CharlieYu4994/ClipperOne/3D_models/3D_printing/rev4/Battery Plate_rev4_finalAdjustment.stl

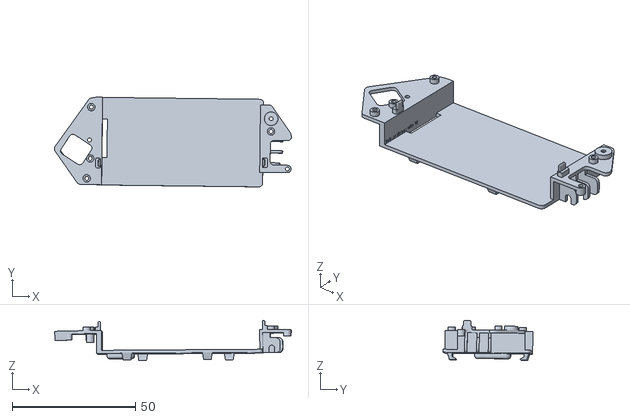
[picture p1: CAD file, 2024-11-09]
3D_models/3D_printing/rev4/Battery Plate_rev4_finalAdjustment.stl
96.0 x 36.4 x 16.3
