CharlieYu4994/ClipperOne/3D_models/3D_printing/rev4/light_guide_group_x5.stl

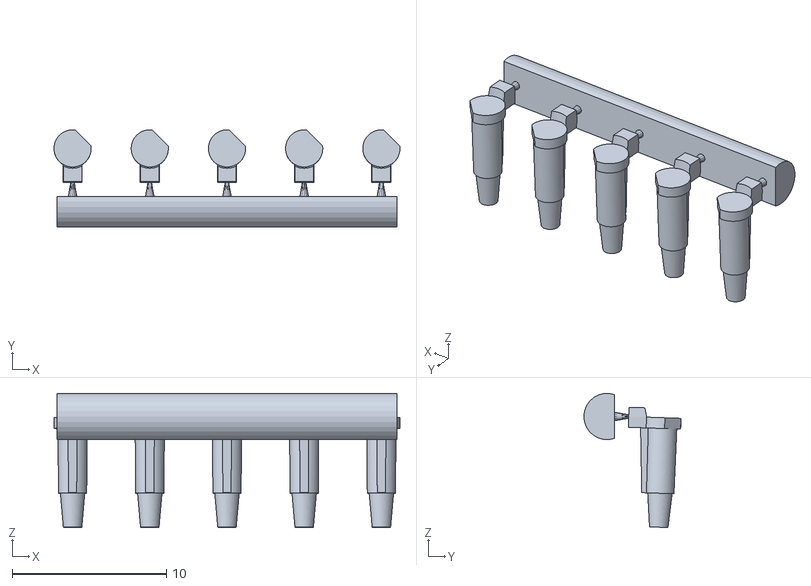
[picture p2: CAD file, 2024-11-09]
3D_models/3D_printing/rev4/light_guide_group_x5.stl
22.4 x 6.30 x 8.69
