CharlieYu4994/ClipperOne/3D_models/3D_printing/rev4/sd lanyard bracket_rev2_fixBreak.stl

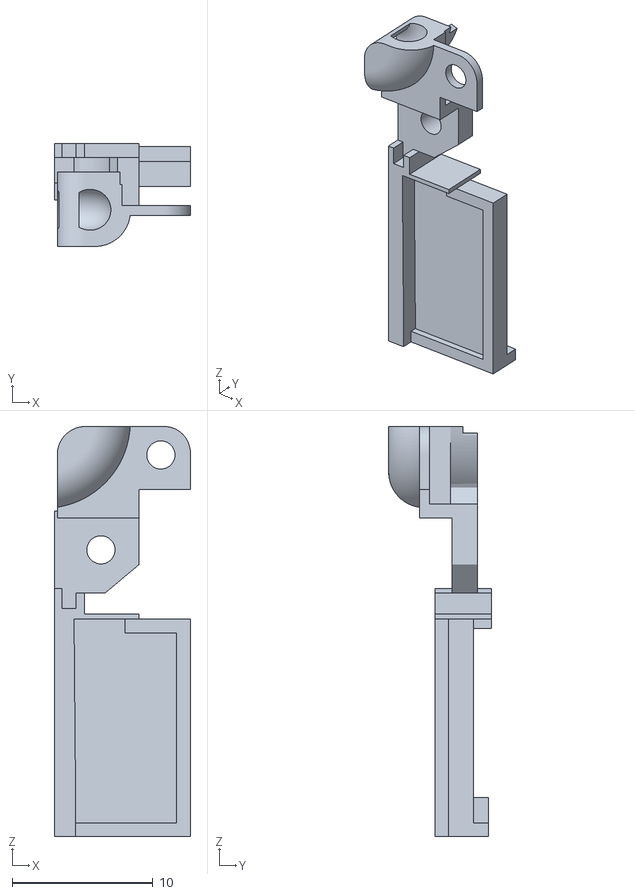
[picture p3: CAD file, 2024-11-09]
3D_models/3D_printing/rev4/sd lanyard bracket_rev2_fixBreak.stl
9.66 x 7.30 x 29.1
