CharlieYu4994/ClipperOne/3D_models/3D_printing/rev4/button_ok.stl

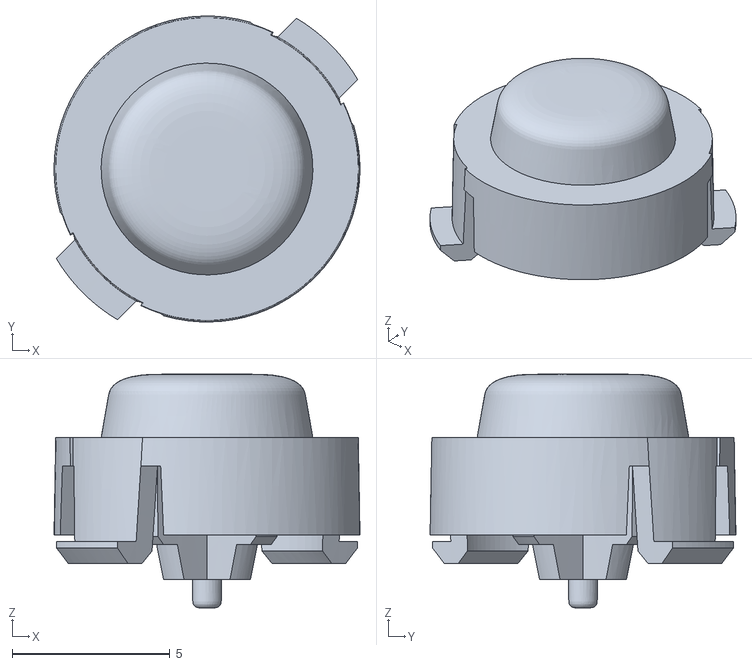
[picture p4: CAD file, 2024-11-09]
3D_models/3D_printing/rev4/button_ok.stl
9.69 x 9.69 x 7.40
