CharlieYu4994/ClipperOne/3D_models/3D_printing/rev4/上盖.stl

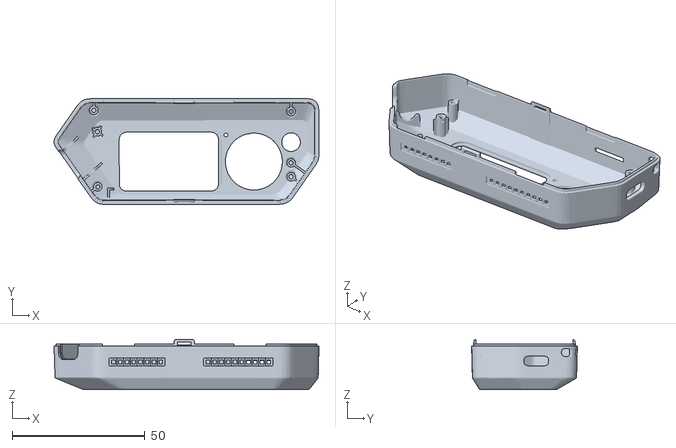
[picture p5: CAD file, 2024-11-09]
3D_models/3D_printing/rev4/上盖.stl
100.0 x 40.0 x 18.9
