CharlieYu4994/ClipperOne/3D_models/3D_printing/rev4/button_ring.stl

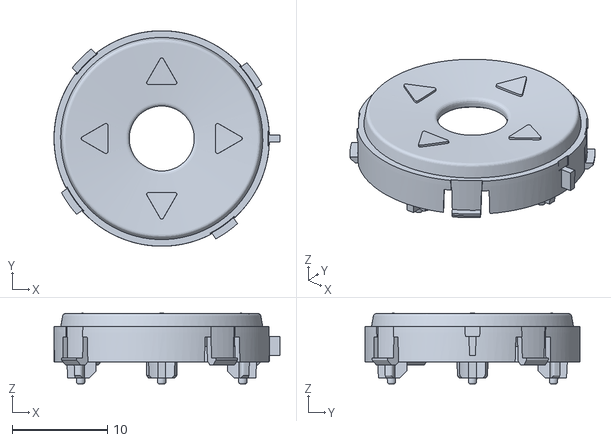
[picture p6: CAD file, 2024-11-09]
3D_models/3D_printing/rev4/button_ring.stl
23.7 x 22.6 x 7.43
