CharlieYu4994/ClipperOne/3D_models/3D_printing/rev4/下盖_rev2_fixHole.stl

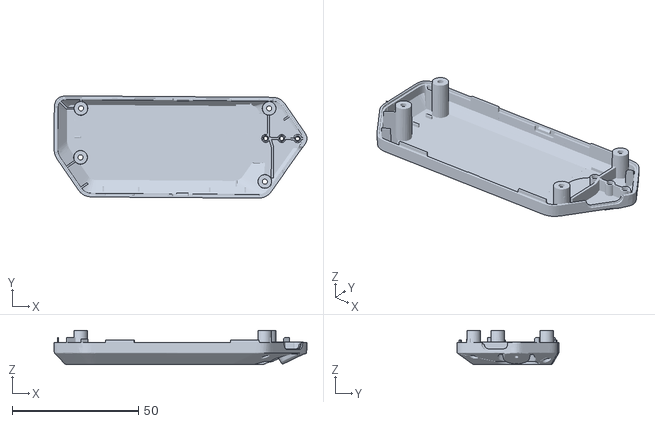
[picture p7: CAD file, 2024-11-09]
3D_models/3D_printing/rev4/下盖_rev2_fixHole.stl
100.0 x 40.4 x 13.5
