CharlieYu4994/ClipperOne/3D_models/3D_printing/rev4/button_back.stl

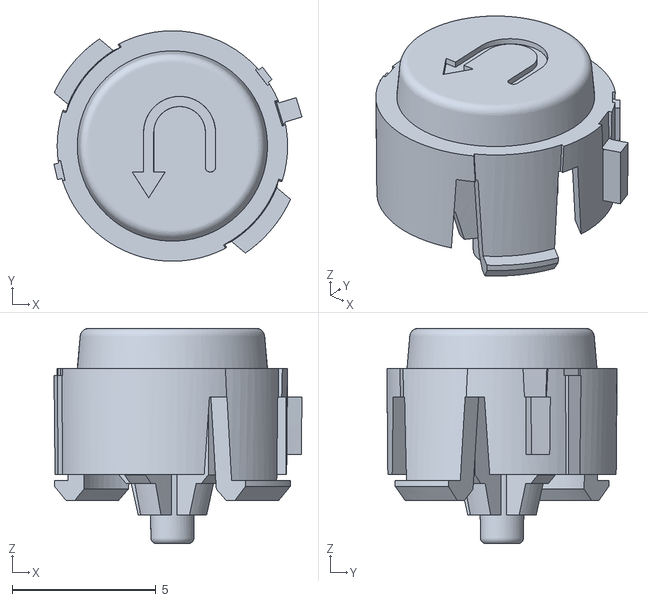
[picture p8: CAD file, 2024-11-09]
3D_models/3D_printing/rev4/button_back.stl
8.64 x 8.02 x 7.50
