CharlieYu4994/ClipperOne/Hardware/iButton/iButton.kicad_pcb

## KiCad design Hardware/iButton/iButton.kicad_pcb (2024-11-03)

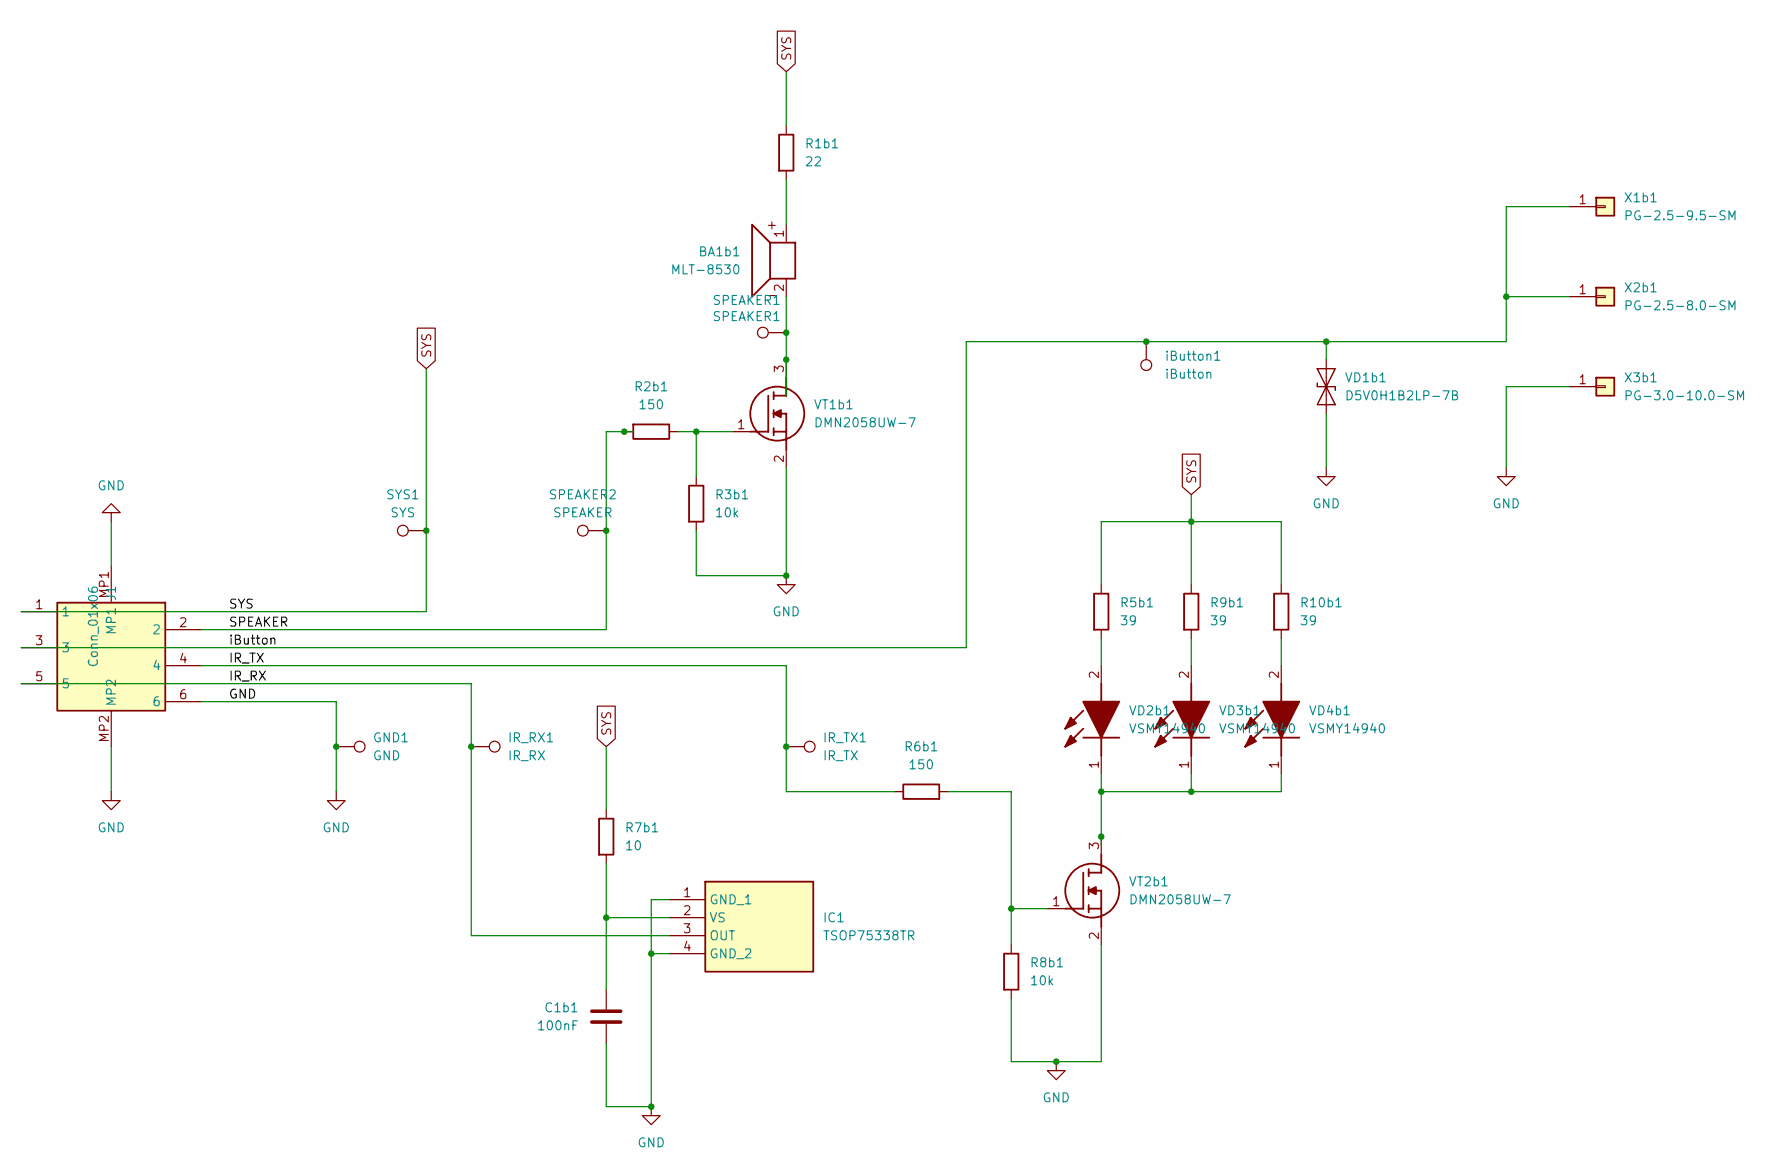
[picture p9: schematic iButton.kicad_sch]

Parts:
BA1b1: MLT-8530; MLT8530
C1b1: 100nF; C_0402_1005Metric
GND1: GND; TestPoint_Pad_D1.0mm
IC1: TSOP75338TR; Manufacturer_Part_Number TSOP75338TR; Mouser Part Number 78-TSOP75338TR
IR_RX1: IR_RX; TestPoint_Pad_D1.0mm
IR_TX1: IR_TX; TestPoint_Pad_D1.0mm
J1: Conn_01x06; AFC11S06ICC00; Manufacturer_Part_Number AFC11-S06ICC-00
R1b1: 22; R_0402_1005Metric
R2b1, R6b1: 150; R_0402_1005Metric
R3b1, R8b1: 10k; R_0402_1005Metric
R5b1, R9b1, R10b1: 39; R_0402_1005Metric
R7b1: 10; R_0402_1005Metric
SPEAKER1: SPEAKER1; TestPoint_Pad_D1.0mm
SPEAKER2: SPEAKER; TestPoint_Pad_D1.0mm
SYS1: SYS; TestPoint_Pad_D1.0mm
VD1b1: D5V0H1B2LP-7B; D5V0H1B2LP7B
VD2b1, VD3b1, VD4b1: VSMY14940; LEDC3012X261N; Manufacturer_Part_Number VSMY14940; Mouser Part Number 782-VSMY14940
VT1b1, VT2b1: DMN2058UW-7; SOT65P210X110-3N; Manufacturer_Part_Number AO3400A
X1b1: PG-2.5-9.5-SM; TestPoint_Pad_D2.0mm
X2b1: PG-2.5-8.0-SM; TestPoint_Pad_D2.0mm
X3b1: PG-3.0-10.0-SM; TestPoint_Pad_D2.0mm
iButton1: iButton; TestPoint_Pad_D1.0mm

Connections:
/IR_RX: IC1.3 (OUT), IR_RX1.1, J1.5
/IR_TX: IR_TX1.1, J1.4, R6b1.1
/SPEAKER: J1.2, R2b1.2, SPEAKER2.1
/iButton: J1.3, VD1b1.2 (A2), X1b1.1, X2b1.1, iButton1.1
GND: C1b1.2, GND1.1, IC1.1 (GND_1), IC1.4 (GND_2), J1.6, J1.MP1, J1.MP2, R3b1.2, R8b1.2, VD1b1.1 (A1), VT1b1.2 (S), VT2b1.2 (S), X3b1.1
unnamed: BA1b1.1 (+), R1b1.2
unnamed: BA1b1.2 (-), SPEAKER1.1, VT1b1.3 (D)
unnamed: C1b1.1, IC1.2 (VS), R7b1.2
unnamed: R5b1.2, VD2b1.2 (A)
unnamed: VD2b1.1 (K), VD3b1.1 (K), VD4b1.1 (K), VT2b1.3 (D)
unnamed: R9b1.2, VD3b1.2 (A)
unnamed: R10b1.2, VD4b1.2 (A)
unnamed: R2b1.1, R3b1.1, VT1b1.1 (G)
unnamed: R6b1.2, R8b1.1, VT2b1.1 (G)
SYS: J1.1, R1b1.1, R5b1.1, R7b1.1, R9b1.1, R10b1.1, SYS1.1

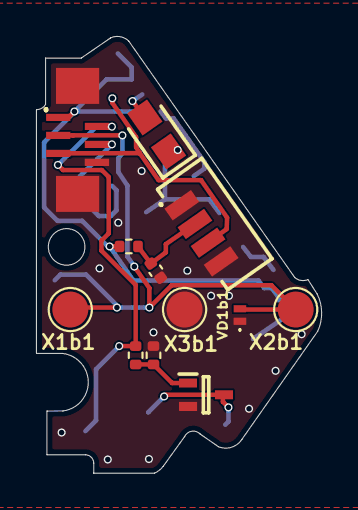
[picture p10: board iButton.kicad_pcb from above]

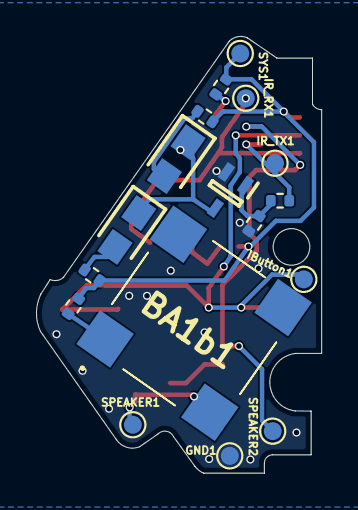
[picture p11: board iButton.kicad_pcb from below]

Board: 2 copper layers, 15.8 x 24.3 mm, 29 parts (17 on the bottom side), 15 nets.
