CharlieYu4994/ClipperOne/Hardware/main_board/main_board.kicad_pcb

## KiCad design Hardware/main_board/main_board.kicad_pcb (2024-11-11)

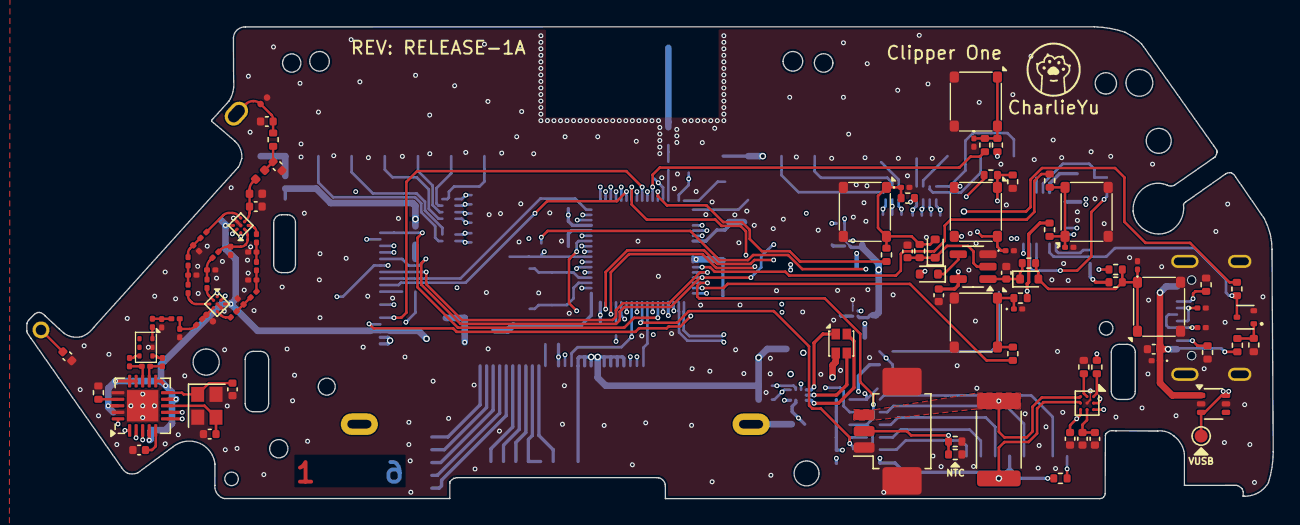
[picture p12: board main_board.kicad_pcb from above]

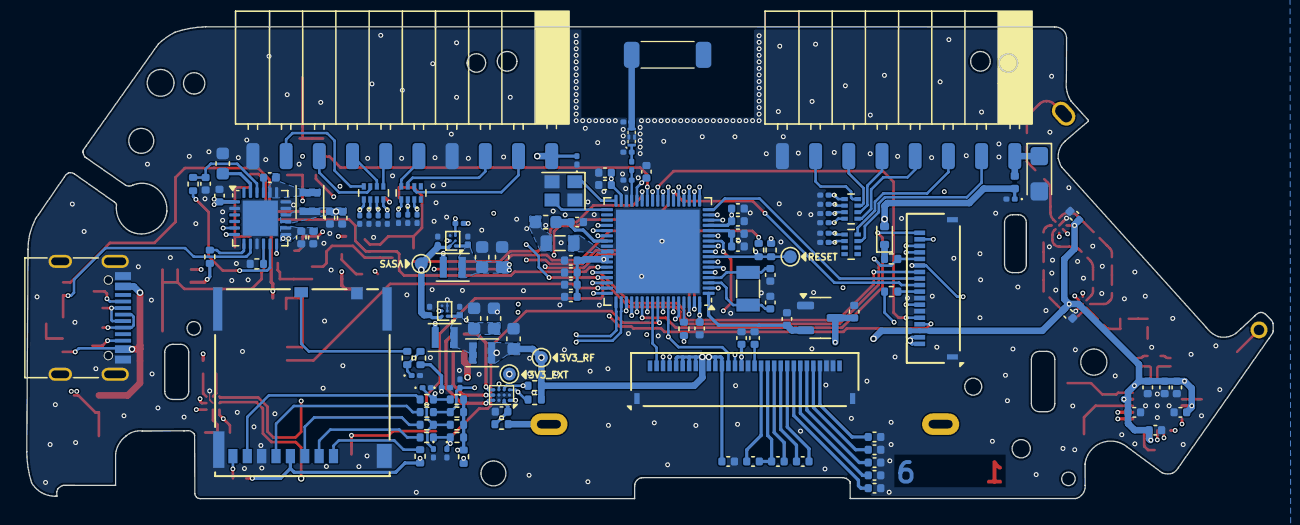
[picture p13: board main_board.kicad_pcb from below]

Board: 6 copper layers, 95.4 x 36.1 mm, 238 parts (136 on the bottom side), 165 nets.

Parts:
AE1: CrossAir C3; CrossAir-C3
AE2: Sub 1G; ANT_SUB1G
C1, C7, C11, C28: 4.7uF; C_0402_1005Metric
C2, C3, C4, C5, C8, C13, C40, C41, C42, C43, C44, C45, C46, C66, C69, C80, C82: 100nF; C_0402_1005Metric
C6, C70: 100pF; C_0402_1005Metric
C9, C12, C18, C24, C32, C33: 1uF; C_0402_1005Metric
C10, C54, C55: 10nF; C_0402_1005Metric
C14: 0.3pF; C_0201_0603Metric
C15: 0.8pF; C_0201_0603Metric
C16, C17: 18pF; C_0402_1005Metric
C19: 47nF; C_0402_1005Metric
C20, C21, C26, C27, C67, C68: 10uF; C_0402_1005Metric
C22: 470nF; C_0402_1005Metric
C23, C73, C79: 2.2uF; C_0402_1005Metric
C25, C31, C37, C38: 10uF; C_0603_1608Metric
C29, C35: 1uF; C_0201_0603Metric
C30, C36: 4.7uF; C_0603_1608Metric
C34, C39: 2.2uF; C_0201_0603Metric
C47, C49: 100pF; C_0201_0603Metric
C48: 0.6pF; C_0201_0603Metric
C50, C56, C57, C65: TBD; C_0201_0603Metric
C51: 1.2pF; C_0201_0603Metric
C52, C53: 9pF; C_0402_1005Metric
C58, C62, C63, C71, C72, C74, C75, C76, C77, C78, C83: TBD; C_0402_1005Metric
C59, C60: 10pF; C_0201_0603Metric
C61: 22pF; C_0201_0603Metric
C64: 8.2pF; C_0201_0603Metric
C81: TBD; CP_EIA-3216-18_Kemet-A
D1, D2, D3, D4, D5, D6, D11, D12, D13, D14, D15, D16, D18, D19, D20, D21, D22, D23, D24, D25, D26, D27, D28, D29, D30, D31, D32, D33, D34, D35: TVS; D_0201_0603Metric
D7, D8, D9, D17: 1N4148; D_SOD-523
D10: LED_RBGA; LTST-C19HE1WT_LTO
F1: 2A; Fuse_0402_1005Metric
FL1: DLF162500LT-5028A1; DLF162500LT
J1: BATT; Molex_PicoBlade_53261-0371_1x03-1MP_P1.25mm_Horizontal
J2: LCD; CONN30x1_FH34SRJ-30S-0.5SH50_HIR
J3: BACK_LIGHT; ERC12864FAMF03
J4: SD; CONN_503398-1892_MOL
J5: NFC; CONN18x1_FH34SRJ-18S-0.5SH50_HIR
J6: EXT1; PinSocket_1x10_P2.54mm_Horizontal_SMD
J7: EXT0; PinSocket_1x08_P2.54mm_Horizontal_SMD
J8: USB_C; USB_C_Receptacle_G-Switch_GT-USB-7010ASV
L1: 10uH; L_0603_1608Metric
L2: 10uH; L_0805_2012Metric
L3, L20, L21: 2.7nH; L_0201_0603Metric
L4: 1uH; L_Murata_DFE201610P
L5, L6, L7: 470nH; L_Murata_DFE201610P
L8: 3.3nH; L_0201_0603Metric
L9: 6.8nH; L_0201_0603Metric
L10, L11, L13, L15, L19: 0; L_0201_0603Metric
L12: 56nH; L_0201_0603Metric
L14: 27nH; L_0201_0603Metric
L16: 22nH; L_0201_0603Metric
L17: 2.2nH; L_0402_1005Metric
L18: TBD; L_0402_1005Metric
Q1: DMN313DLT; SOT-523
R1, R45, R46, R47, R50: 51R; R_0402_1005Metric
R2, R3, R8, R11, R12, R14, R19, R20, R21, R22, R23, R30, R31: 10K; R_0402_1005Metric
R4: 470R; R_0402_1005Metric
R5: 10m; R_2512_6332Metric
R6, R7, R51, R52: 5.1K; R_0402_1005Metric
R9: 5.23K; R_0402_1005Metric
R10: 30.1K; R_0402_1005Metric
R13: 100R; R_0402_1005Metric
R15: 10K; R_0201_0603Metric
R16: 0R; R_0201_0603Metric
R17: 56K/0.1%; R_0402_1005Metric
R18, R35, R36: 0R; R_0402_1005Metric
R24, R25, R26, R27, R28, R29, R33: 330R; R_0402_1005Metric
R32, R34: 100K; R_0402_1005Metric
R37, R38, R39, R40, R41, R42, R43: 47K; R_0402_1005Metric
R44, R48: 150R; R_0402_1005Metric
R49: 1K; R_0402_1005Metric
RFF**: CharlieYu; charlieyu
RN1, RN2, RN3, RN4: 51R; R_Array_Concave_4x0402
SW1: OK; SW_Push_SPST_NO_Alps_ SKRM
SW2: BACK; SW_Push_SPST_NO_Alps_ SKRM
SW3: RIGHT; SW_Push_SPST_NO_Alps_ SKRM
SW4: LEFT; SW_Push_SPST_NO_Alps_ SKRM
SW5: UP; SW_Push_SPST_NO_Alps_ SKRM
SW6: DOWN; SW_Push_SPST_NO_Alps_ SKRM
T1: B0310J50100AHF
TP1: RST; TestPoint_Pad_D1.0mm
TP12: 5V_USB; TestPoint_Pad_D1.0mm
TP18: VSYS; TestPoint_Pad_D1.0mm
TP20: 3V3_MAIN; TestPoint_Pad_D1.0mm
TP21: 3V3_EXT; TestPoint_Pad_D1.0mm
TP32: Balun; TP_DP
TP33: CC1101_OUT; TP_DP
U1: STM32WB55RGVx; QFN-68-1EP_8x8mm_P0.4mm_EP6.4x6.4mm
U2: BQ27220YZFR; Texas_DSBGA-9_1.62mmx1.58mm_Layout3x3_P0.5mm
U3: BQ25896RTWR; Texas_RTW_WQFN-24-1EP_4x4mm_P0.5mm_EP2.7x2.7mm
U4: RS3221-3.3YF3; SOT-23-3
U5: LM66100DCK; SOT-363_SC-70-6
U6, U7: LM3281YFQR; BGA-6_2x3_1.16x1.435mm
U8: CC1101RGP; Texas_RGP0020H_VQFN-20-1EP_4x4mm_P0.5mm_EP2.4x2.4mm
U9, U10: BGS13S4N9E6327XTSA1; BGA-9_3x3_1.2x1.2mm
U11: NC7SZ32M5X; SOT-23-5
U12: LP5562TMX; BGA-12_4x3_1.6x1.2mm
Y1: 32MHz; Crystal_SMD_2520-4Pin_2.5x2.0mm
Y2: 32.768K; Crystal_SMD_3215-2Pin_3.2x1.5mm
Y3: 26MHz; Crystal_SMD_2520-4Pin_2.5x2.0mm

Connections:
+3.3V: C1.2, C2.2, C3.2, C4.2, C5.2, C6.2, C7.2, C8.2, C9.2, C10.2, C38.2, C40.2, C41.2, C42.2, C43.2, C44.2, C45.2, C54.1, C55.1, C66.1, C69.2, C70.2, J2.5, J2.6, J2.7, J2.8, J2.9, J2.10, J2.11, J2.12, J2.15, J5.3, L7.2, R2.1, R6.2, R7.2, R8.2, R15.1, R19.2, R20.2, R21.2, R22.2, R23.2, R31.2, SW1.2, TP20.1, U1.14 (VDDA), U1.30 (VDD), U1.33 (VDDRF), U1.44 (VDDSMPS), U1.45 (VDD), U1.55 (VDDUSB), U1.68 (VDD), U8.4 (DVDD), U8.9 (AVDD), U8.11 (AVDD), U8.14 (AVDD), U8.15 (AVDD), U8.18 (DGUARD), U9.A3 (VDD), U10.A3 (VDD), U11.5 (VCC)
+3.3V_EXT: C30.2, C31.2, C34.2, D18.2 (A2), J6.1, L5.2, R36.1, TP21.1, U6.A1 (FB)
+3.3V_LDO: C33.2, U1.1 (VBAT), U4.2 (VOUT)
/Buttons/BACK: D2.1 (A1), D7.2 (A), R19.1, R25.2, R32.2, SW2.1
/Buttons/BUTTON_BACK: R25.1, U1.2 (PC13), U3.12 (QON_N)
/Buttons/BUTTON_DOWN: R29.1, U1.50 (PC6)
/Buttons/BUTTON_LEFT: R27.1, U1.29 (PB11)
/Buttons/BUTTON_OK: R24.1, U1.5 (PH3)
/Buttons/BUTTON_RIGHT: R26.1, U1.46 (PB12)
/Buttons/BUTTON_UP: R28.1, U1.28 (PB10)
/Buttons/LEFT: D4.1 (A1), D9.2 (A), R21.1, R27.2, R34.2, SW4.1
/Buttons/RESET: R31.1, R33.1, TP1.1, U1.8 (NRST), U12.C3 (EN_VCC)
/CC1101/CC1101_CS: U1.61 (PD0), U8.7 (CSN)
/CC1101/CC1101_G0: U1.16 (PA1), U8.6 (GDO0)
/CC1101/CC1101_UBAL: R16.2, TP32.1, U9.C2 (RFIN)
/CC1101/RF_SW_0: U1.25 (PC4), U9.A2 (V2), U10.A1 (V1)
/CC1101/RF_SW_1: U8.3 (GD02), U9.A1 (V1), U10.A2 (V2)
/CC1101/SPI_R_MISO: R50.1, U1.64 (PB4), U8.2 (SO)
/CC1101/SPI_R_MOSI: J5.13, R1.2, U8.20 (SI)
/CC1101/SPI_R_SCK: J5.7, U1.20 (PA5), U8.1 (SCLK)
/LCD/DISPLAY_CS: J2.2, U1.59 (PC11)
/LCD/DISPLAY_DI: J2.4, U1.39 (PB1)
/LCD/DISPLAY_RST: J2.3, U1.38 (PB0)
/LCD/LCD_LED: J3.1 (K), U12.A1 (W)
/LCD/SPI_D_MOSI: D12.1 (A1), J2.14, R38.1, R45.1, U1.49 (PB15)
/LCD/SPI_D_SCK: D13.1 (A1), J2.13, R39.1, R46.1, U1.62 (PD1)
/MCU/D+: D35.1 (A1), J8.A6 (D+), J8.B6 (D+), U1.53 (PA12)
/MCU/D-: D34.1 (A1), J8.A7 (D-), J8.B7 (D-), U1.52 (PA11)
/MCU/I2C_SCL: R7.1, U1.24 (PA9), U2.A3 (SCL), U3.5 (SCL), U12.C2 (SCL)
/MCU/I2C_SDA: R6.1, U1.51 (PA10), U2.A2 (SDA), U3.6 (SDA), U12.C1 (SDA)
/MCU/IR_RX: J5.17, U1.15 (PA0)
/MCU/IR_TX: J5.16, U1.7 (PB9)
/MCU/NFC_CS: J5.4, U1.40 (PE4)
/MCU/PA4: D22.1 (A1), RN3.8, U1.19 (PA4)
/MCU/PA6: D21.1 (A1), RN1.5, U1.21 (PA6)
/MCU/PA7: D20.1 (A1), RN1.6, U1.22 (PA7)
/MCU/PB2: D24.1 (A1), RN3.6, U1.27 (PB2)
/MCU/PB3: D23.1 (A1), RN3.7, U1.63 (PB3)
/MCU/PC0: D31.1 (A1), RN4.6, U1.9 (PC0)
/MCU/PC1: D30.1 (A1), RN4.7, U1.10 (PC1)
/MCU/PC3: D25.1 (A1), RN3.5, U1.12 (PC3)
/MCU/PERI_EN: R15.2, U1.18 (PA3), U6.C1 (EN)
/MCU/RFID_CARRIER: J5.18, U1.57 (PA15)
/MCU/RFID_OUT: J5.12, U1.47 (PB13)
/MCU/RFID_PULL: J5.11, U1.17 (PA2)
/MCU/RFID_RF_IN: J5.5, U1.26 (PC5)
/MCU/SD_CD: D15.1 (A1), R41.1, R48.1, U1.58 (PC10)
/MCU/SD_CS: D11.1 (A1), R37.1, R44.1, U1.60 (PC12)
/MCU/SPEAKER: J5.15, U1.6 (PB8)
/MCU/SPI_D_MISO: D14.1 (A1), R40.1, R47.1, U1.11 (PC2)
/MCU/SWCLK: D26.1 (A1), RN2.7, U1.56 (PA14)
/MCU/SWDIO: D27.1 (A1), RN2.6, U1.54 (PA13)
/MCU/UART1_RX: D29.1 (A1), RN4.8, U1.67 (PB7)
/MCU/UART1_TX: D28.1 (A1), RN2.5, U1.66 (PB6)
/MCU/VIBRO: J5.10, U1.23 (PA8)
/MCU/iBTN: D32.1 (A1), J5.14, R49.2, RN4.5, U1.48 (PB14)
/Power/BAT+: C18.2, J1.3, R5.2, U2.C1 (SRP), U2.C3 (BAT)
BAT: C26.2, C27.2, C32.2, R5.1, U2.C2 (SRN), U3.13 (BAT), U3.14 (BAT), U4.3 (VIN)
GND: C1.1, C2.1, C3.1, C4.1, C5.1, C6.1, C7.1, C8.1, C9.1, C10.1, C11.1, C12.1, C13.1, C14.1, C15.1, C16.1, C17.1, C18.1, C20.1, C21.1, C22.1, C23.1, C24.1, C25.1, C26.1, C27.1, C28.1, C29.1, C30.1, C31.1, C32.1, C33.1, C34.1, C35.1, C36.1, C37.1, C38.1, C39.1, C40.1, C41.1, C42.1, C43.1, C44.1, C45.1, C46.2, C50.1, C51.1, C52.1, C53.1, C54.2, C55.2, C56.2, C57.2, C58.2, C59.1, C60.1, C61.1, C62.1, C63.1, C64.1, C65.1, C66.2, C67.1, C68.1, C69.1, C70.1, C71.1, C75.1, C76.1, C77.1, C78.1, C79.1, C80.2, C81.2, C82.2, C83.1, D1.2 (A2), D2.2 (A2), D3.2 (A2), D4.2 (A2), D5.2 (A2), D6.2 (A2), D11.2 (A2), D12.2 (A2), D13.2 (A2), D14.2 (A2), D15.2 (A2), D16.2 (A2), D18.1 (A1), D19.2 (A2), D20.2 (A2), D21.2 (A2), D22.2 (A2), D23.2 (A2), D24.2 (A2), D25.2 (A2), D26.2 (A2), D27.2 (A2), D28.2 (A2), D29.2 (A2), D30.2 (A2), D31.2 (A2), D32.2 (A2), D33.2 (A2), D34.2 (A2), D35.2 (A2), FL1.2 (GND), FL1.4 (GND), J1.1, J1.MP (MountPin), J2.16, J2.28, J2.29, J2.MP (MountPin), J4.6 (VSS), J4.10 (SHIELD), J5.6, J5.8, J5.MP (MountPin), J6.4, J6.10, J7.8, J8.A1 (GND), J8.A12 (GND), J8.B1 (GND), J8.B12 (GND), J8.S1 (SHIELD), L18.1, L21.1, Q1.2 (S), R3.2, R4.1, R10.1, R11.1, R14.1, R17.2, R30.1, R51.1, R52.1, SW2.2, SW3.2, SW4.2, SW5.2, SW6.2, T1.2 (GND), TP32.2, TP33.2, U1.32 (VSSRF), U1.42 (VSSSMPS), U1.69 (VSS), U2.B2 (VSS), U3.2 (PSEL), U3.9 (CE_N), U3.17 (PGND), U3.18 (PGND), U3.25 (PAD), U4.1 (GND), U5.2 (GND), U5.5 (ST), U6.C2 (EPAD), U7.B1 (MODE), U7.C1 (EN), U7.C2 (EPAD), U8.16 (GND), U8.19 (GND), U8.21 (EPAD), U9.B2 (GND), U9.B3 (DGND), U10.B2 (GND), U10.B3 (DGND), U11.3 (GND), U12.A3 (CLK_32K), U12.B1 (A1), U12.B2 (A0), U12.B3 (GND), Y1.2, Y1.4, Y3.2, Y3.4
unnamed: AE1.1 (FEED), FL1.3 (OUT), L21.2
unnamed: AE2.1 (A), C63.2, R18.2, TP33.1
unnamed: AE2.2 (Shield), C83.2
unnamed: C47.2, T1.4 (Bal)
unnamed: C49.2, T1.3 (Bal)
unnamed: C50.2, L8.2, L9.1
unnamed: C51.2, L9.2, R16.1
unnamed: C56.1, L10.2, L11.1
unnamed: C57.1, L11.2, L12.1
unnamed: C59.2, L13.2, L14.1
unnamed: C60.2, L14.2, L15.1
unnamed: C61.2, L15.2, L16.1
unnamed: C62.2, L17.2, R18.1
unnamed: C64.2, L19.2, L20.1
unnamed: D1.1 (A1), R24.2, R30.2, SW1.1
unnamed: D3.1 (A1), R20.1, R26.2, SW3.1
unnamed: D5.1 (A1), R22.1, R28.2, SW5.1
unnamed: D6.1 (A1), R23.1, R29.2, SW6.1
unnamed: C67.2, D7.1 (K), R32.1, U11.1
unnamed: D8.2 (A), R33.2
unnamed: D8.1 (K), U11.4
unnamed: C68.2, D9.1 (K), R34.1, U11.2
unnamed: D10.2 (BK), U12.A4 (B)
unnamed: D10.3 (GK), U12.B4 (G)
unnamed: D10.1 (RK), U12.C4 (R)
unnamed: D16.1 (A1), J4.4 (VDD), R36.2, R37.2, R38.2, R39.2, R40.2, R41.2, R42.2, R43.2
unnamed: D17.1 (K), R49.1
unnamed: C14.2, FL1.1 (IN), L3.1
unnamed: J1.2, R9.2, R10.2, R11.2, U3.11 (TS)
unnamed: C71.2, J2.17
unnamed: C72.2, J2.18
unnamed: C72.1, C73.2, J2.19
unnamed: C73.1, J2.20
unnamed: C74.2, J2.21
unnamed: C74.1, J2.22
unnamed: C75.2, J2.23
unnamed: C76.2, J2.24
unnamed: C77.2, J2.25
unnamed: C78.2, J2.26
unnamed: C79.2, J2.27
unnamed: J3.2 (A), R35.1
unnamed: J4.5 (CLK), R46.2
unnamed: J4.3 (CMD), R45.2
unnamed: J4.7 (DAT0), R47.2
unnamed: J4.8 (DAT1), R42.1
unnamed: J4.1 (DAT2), R43.1
unnamed: J4.2 (DAT3/CD), R44.2
unnamed: J4.9 (DET), R48.2
unnamed: J5.9, R50.2
unnamed: J6.2, RN2.2
unnamed: J6.3, RN2.3
unnamed: J6.5, RN2.4
unnamed: J6.6, RN4.1
unnamed: J6.7, RN4.2
unnamed: J6.8, RN4.3
unnamed: J6.9, RN4.4
unnamed: C81.1, F1.2, J7.1
unnamed: J7.2, RN1.3
unnamed: J7.3, RN1.4
unnamed: J7.4, RN3.1
unnamed: J7.5, RN3.2
unnamed: J7.6, RN3.3
unnamed: J7.7, RN3.4
unnamed: J8.A5 (CC1), R52.2
unnamed: J8.B5 (CC2), R51.2
unnamed: L1.2, L2.1
unnamed: Q1.3 (D), R12.2, U3.8 (OTG_IUSB)
unnamed: Q1.1 (G), R13.2, R14.2
unnamed: L8.1, T1.1 (Unbal)
unnamed: U1.35 (OSC_IN), Y1.3
unnamed: U1.34 (OSC_OUT), Y1.1
unnamed: R1.1, U1.65 (PB5)
unnamed: C16.2, U1.3 (PC14), Y2.2
unnamed: C17.2, U1.4 (PC15), Y2.1
unnamed: C15.2, L3.2, U1.31 (RF1)
unnamed: C11.2, L1.1, U1.41 (VFBSMPS)
unnamed: L2.2, U1.43 (VLXSMPS)
unnamed: C12.2, C13.2, U1.13 (VREF+)
unnamed: R3.1, U2.B1 (BIN)
unnamed: R2.2, U2.A1 (GPOUT)
unnamed: C22.2, C23.2, U2.B3 (VDD)
unnamed: C19.1, U3.21 (BTST)
unnamed: R4.2, U3.10 (ILIM)
unnamed: R8.1, U3.7 (INT)
unnamed: C25.2, U3.23 (PMID)
unnamed: C28.2, R9.1, U3.22 (REGN)
unnamed: L5.1, U6.B2 (SW)
unnamed: C36.2, C37.2, C39.2, L6.2, L7.1, U7.A1 (FB)
unnamed: L6.1, U7.B2 (SW)
unnamed: C46.1, U8.5 (DCOUPL)
unnamed: R17.1, U8.17 (RBIAS)
unnamed: C47.1, C48.1, U8.13 (RF_N)
unnamed: C48.2, C49.1, U8.12 (RF_P)
unnamed: C52.2, U8.8 (XOSC_Q1), Y3.3
unnamed: C53.2, U8.10 (XOSC_Q2), Y3.1
unnamed: L10.1, U9.C1 (RF1)
unnamed: L13.1, U9.C3 (RF2)
unnamed: L19.1, U9.B1 (RF3)
unnamed: L16.2, U10.C1 (RF1)
unnamed: L12.2, U10.C3 (RF2)
unnamed: C65.2, L20.2, U10.B1 (RF3)
unnamed: C58.1, L17.1, L18.2, U10.C2 (RFIN)
SW: C19.2, L4.1, U3.19 (SW), U3.20 (SW)
VBUS: C82.1, D33.1 (A1), J8.A4 (VBUS), J8.A9 (VBUS), J8.B4 (VBUS), J8.B9 (VBUS), R13.1, U5.1 (VIN)
VSYS: C20.2, C21.2, C29.2, C35.2, C80.1, D10.4 (A), L4.2, R12.1, R35.2, TP18.1, U3.15 (SYS), U3.16 (SYS), U6.A2 (VIN), U6.B1 (MODE), U7.A2 (VIN), U12.A2 (VDD)
VUSB: C24.2, D17.2 (A), D19.1 (A1), F1.1, J5.1, J5.2, TP12.1, U3.1 (VBUS), U5.3 (~CE), U5.6 (VOUT)
