CharlieYu4994/ClipperOne/Hardware/nfc_rfid/nfc_rfid.kicad_pcb

## KiCad design Hardware/nfc_rfid/nfc_rfid.kicad_pcb (2024-11-09)

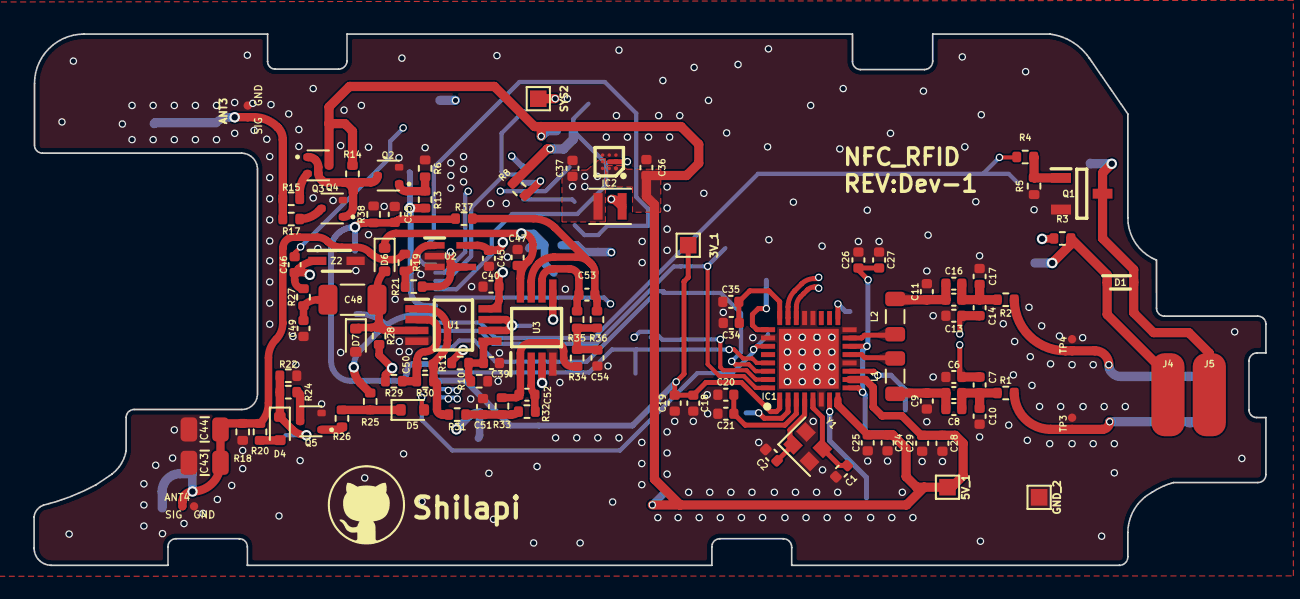
[picture p14: board nfc_rfid.kicad_pcb from above]

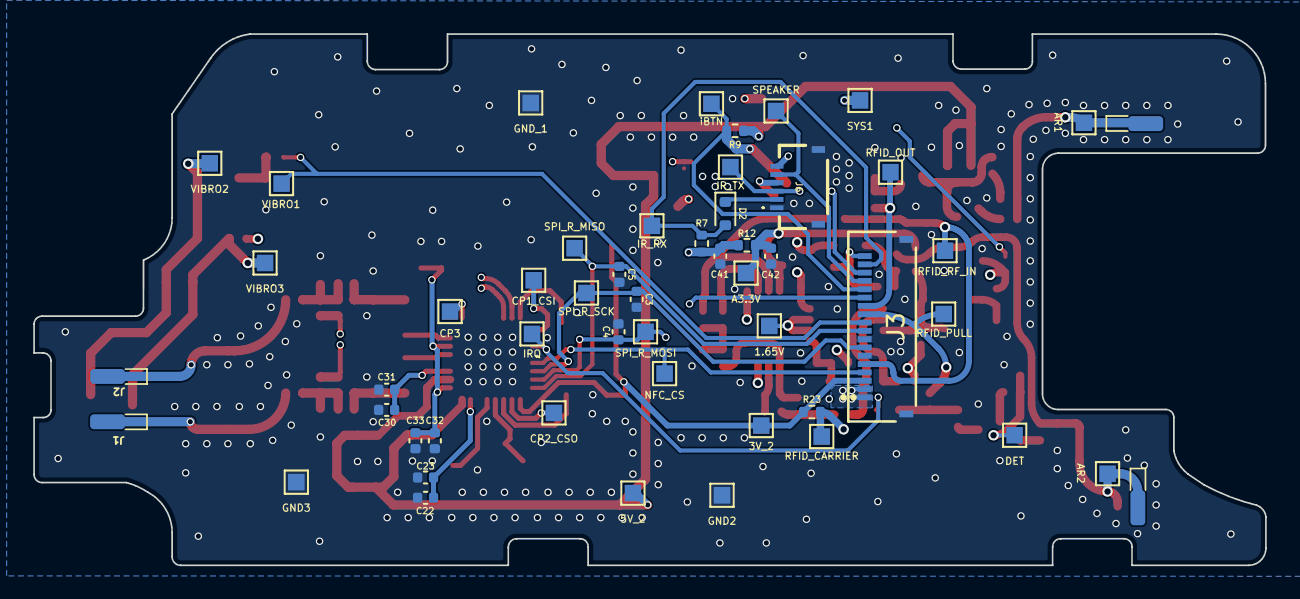
[picture p15: board nfc_rfid.kicad_pcb from below]

Board: 4 copper layers, 74.1 x 32.0 mm, 158 parts (52 on the bottom side), 68 nets.

Parts:
C1, C2: 6pF; C_0402_1005Metric
C3, C4, C5, C12, C15, C50: C; C_0402_1005Metric
C6, C8, C13, C16, C52, C53, C55: 100pF; C_0402_1005Metric
C7, C14: 10pF; C_0402_1005Metric
C9, C11: 680pF; C_0402_1005Metric
C10, C17: 62pF; C_0402_1005Metric
C18, C20, C22, C24, C26, C28, C30, C32, C34, C46: 10nF; C_0402_1005Metric
C19, C21, C23, C25, C27, C29, C31, C33, C35: 2.2uF; C_0402_1005Metric
C36: 22uF; C_0402_1005Metric
C37: 10uF; C_0402_1005Metric
C39, C41, C42: 1uF; C_0402_1005Metric
C40, C45, C47: 100nF; C_0402_1005Metric
C43: 3.3nF; C_0805_2012Metric
C44: C; C_0805_2012Metric
C48: 220nF; C_1206_3216Metric
C49: 1nF; C_0402_1005Metric
C51, C54: 4.7nF; C_0402_1005Metric
D1: 1N4148X-TP; SODFL1608X70N
D2, D4, D5, D6, D7: 1N4148WT; D_SOD-523
IC1: ST25R3916-AQWT; QFN50P500X500X100-33N-D
IC2: FAN48610UC50X; BGA9C40P3X3_122X122X62
J1, J2, J7, J8: BW0033AG-L3.4W0.9H1.8; SMD_L3.4-W0.9
J3: HC-FPC-05-09-18RLTAG; CONN18x1_FH34SRJ-18S-0.5SH50_HIR
J4: +; TestPoint_Pad_3.0x2.0mm_round_corner_no_silkscreen
J5: -; TestPoint_Pad_3.0x2.0mm_round_corner_no_silkscreen
J6: AFH34-S06FIA-1H; AFH34S06FIA1H
L1, L2: 270nH; L_0805_2012Metric
L3: 470nH; L_Murata_DFE201610P
Q1: AO3400A; SOT95P280X125-3N
Q2, Q4: DMN2004TK-7; SOT-523
Q3: DMP2004TK-7; SOT-523
Q5: DMN5L06TK-7; SOT-523
R1, R2: 0Ω; R_0402_1005Metric
R3: 22; R_0402_1005Metric
R4: 150; R_0402_1005Metric
R5, R6, R7, R23, R33, R36: 10k; R_0402_1005Metric
R8, R13: 51; R_0402_1005Metric
R9: 47k; R_0402_1005Metric
R10, R11, R37: 33k; R_0402_1005Metric
R12: 10; R_0402_1005Metric
R14: 510; R_0402_1005Metric
R15, R17: 4.7; R_0402_1005Metric
R18, R21: R; R_0402_1005Metric
R19, R22: 330k; R_0402_1005Metric
R20: 0; R_0402_1005Metric
R24: 330; R_0402_1005Metric
R25, R26: 220; R_0402_1005Metric
R27: 5.1k; R_0402_1005Metric
R28: 1M; R_0402_1005Metric
R29, R31, R32, R34, R35: 1k; R_0402_1005Metric
R30: 4.7k; R_0402_1005Metric
R38: 20k; R_0402_1005Metric
TP1: CP1_CSI; TestPoint_Pad_1.0x1.0mm
TP2: CP2_CSO; TestPoint_Pad_1.0x1.0mm
TP3: ANT1; TP_DP
TP4: ANT2; TP_DP
TP5: CP3; TestPoint_Pad_1.0x1.0mm
TP6: IR_RX; TestPoint_Pad_1.0x1.0mm
TP7: IR_TX; TestPoint_Pad_1.0x1.0mm
TP8: SPEAKER; TestPoint_Pad_1.0x1.0mm
TP9: iBTN; TestPoint_Pad_1.0x1.0mm
TP10: SPI_R_MOSI; TestPoint_Pad_1.0x1.0mm
TP11: RFID_OUT; TestPoint_Pad_1.0x1.0mm
TP12: RFID_PULL; TestPoint_Pad_1.0x1.0mm
TP13: SPI_R_MISO; TestPoint_Pad_1.0x1.0mm
TP14: SPI_R_SCK; TestPoint_Pad_1.0x1.0mm
TP15: RFID_RF_IN; TestPoint_Pad_1.0x1.0mm
TP16: NFC_CS; TestPoint_Pad_1.0x1.0mm
TP17: VIBRO1; TestPoint_Pad_1.0x1.0mm
TP18: RFID_CARRIER; TestPoint_Pad_1.0x1.0mm
TP19: GND2; TestPoint_Pad_1.0x1.0mm
TP20: GND3; TestPoint_Pad_1.0x1.0mm
TP21: VIBRO3; TestPoint_Pad_1.0x1.0mm
TP22: VIBRO2; TestPoint_Pad_1.0x1.0mm
TP23: SYS1; TestPoint_Pad_1.0x1.0mm
TP24: SYS2; TestPoint_Pad_1.0x1.0mm
TP25: 5V_1; TestPoint_Pad_1.0x1.0mm
TP26: 5V_2; TestPoint_Pad_1.0x1.0mm
TP27: 3V_1; TestPoint_Pad_1.0x1.0mm
TP28: 3V_2; TestPoint_Pad_1.0x1.0mm
TP29: GND_1; TestPoint_Pad_1.0x1.0mm
TP30: GND_2; TestPoint_Pad_1.0x1.0mm
TP33: 1.65V; TestPoint_Pad_1.0x1.0mm
TP34: A3.3V; TestPoint_Pad_1.0x1.0mm
TP35: AR1; TestPoint_Pad_1.0x1.0mm
TP36: AR2; TestPoint_Pad_1.0x1.0mm
TP37: ANT3; TP_DP
TP38: ANT4; TP_DP
TP39: DET; TestPoint_Pad_1.0x1.0mm
TP40: IRQ; TestPoint_Pad_1.0x1.0mm
U1, U3: LMV358AIDGKR; SOP65P490X110-8N
U2: LMV331IDCKR; SOT65P210X110-5N
Y1: CF4027M12010001; Crystal_SMD_2016-4Pin_2.0x1.6mm
Z2: BZT52C33S-TP; SOD2512X115N

Connections:
+1.65V: R28.1, R29.2, TP33.1, U1.6 (-), U1.7, U3.3 (+), U3.5 (+)
+3.3V: C18.1, C19.1, C41.1, IC1.1 (VDD_IO), J3.3, R7.1, R12.1, R23.2, TP27.1, TP28.1
+5V: C24.1, C25.1, C28.1, C29.1, C36.1, IC1.8 (VDD), IC1.10 (VDD_TX), IC2.A1 (VOUT_1), IC2.A2 (VOUT_2), Q3.3 (D), R9.1, R14.1, TP25.1, TP26.1
/NFC/EXT_LM: IC1.17 (EXT_LM), TP5.1
/NFC/NFC_ANT1: J1.1, R1.2, TP3.1
/NFC/NFC_ANT2: J2.1, R2.2, TP4.1
/NFC/NFC_CS: IC1.29 (BSS), J3.4, TP16.1
/NFC/NFC_IRQ: D5.2 (A), IC1.27 (IRQ), TP40.1
/NFC/RFI_N: C13.1, C14.1, IC1.23 (RFI2)
/NFC/RFI_P: C6.1, C7.1, IC1.22 (RFI1)
/NFC/SPI_R_MISO: C5.1, IC1.32 (MISO), J3.9, TP13.1
/NFC/SPI_R_MOSI: C4.1, IC1.31 (MOSI), J3.13, TP10.1
/NFC/SPI_R_SCK: C3.1, IC1.30 (SCL), J3.7, TP14.1
/Peripheral/IR_RX: D2.2 (A), J3.17, R7.2, TP6.1
/Peripheral/RFID_CARRIER: C46.1, D4.1 (K), J3.18, R21.2, R22.1, R23.1, R24.2, R27.1, TP18.1, TP39.1, U2.4, Z2.1 (K)
/Peripheral/RFID_OUT: J3.12, R13.1, TP11.1
/Peripheral/RFID_PULL: J3.11, R25.1, TP12.1
/Peripheral/RFID_RF_IN: C55.2, J3.5, R37.2, R38.1, TP15.1
/Peripheral/iBTN: C46.2, J3.14, R8.1, R9.2, TP9.1
/RFID_iBTN/IR_TX: J3.16, J6.3, TP7.1
/RFID_iBTN/SPEAKER: J3.15, J6.5, TP8.1
/RFID_iBTN/TSOP_RX: D2.1 (K), J6.2
A+3.3V: C40.2, C42.1, C45.1, C47.2, D6.1 (K), R11.1, R12.2, TP34.1, U1.8 (V+), U2.5 (V+), U3.8 (V+)
GND: C1.1, C2.1, C3.2, C4.2, C5.2, C6.2, C9.2, C10.2, C11.2, C13.2, C17.1, C18.2, C19.2, C20.2, C21.2, C22.2, C23.2, C24.2, C25.2, C26.2, C27.2, C28.2, C29.2, C30.2, C31.2, C32.2, C33.2, C34.2, C35.2, C36.2, C37.2, C39.2, C40.1, C41.2, C42.2, C43.2, C44.2, C45.2, C47.1, C49.2, C51.1, C54.1, C55.1, D7.2 (A), IC1.6 (GND_D), IC1.12 (GND_DR_1), IC1.16 (GND_DR_2), IC1.20 (I2C_EN), IC1.21 (VSS), IC1.26 (GND_A), IC1.33 (EPAD), IC2.C1 (PGND_1), IC2.C2 (PGND_2), IC2.C3 (AGND), J3.6, J3.8, J3.19, J3.20, J6.1, J6.7 (MP1), J6.8 (MP2), Q1.2 (S), Q2.2 (S), Q4.2 (S), Q5.2 (S), R5.2, R6.2, R10.2, R18.2, R22.2, R38.2, TP3.2, TP4.2, TP19.1, TP20.1, TP29.1, TP30.1, TP37.2, TP38.2, U1.4 (V-), U2.2 (V-), U2.3 (-), U3.4 (V-), Y1.2, Y1.4, Z2.2 (A)
unnamed: C7.2, C8.2, C10.1, C12.2, R1.1
unnamed: C11.1, C15.1, C16.1, L2.2
unnamed: C8.1, C9.1, C12.1, L1.2
unnamed: C14.2, C15.2, C16.2, C17.2, R2.1
unnamed: C48.1, C49.1, R27.2
unnamed: C50.2, R30.1, R31.2, U1.1
unnamed: C51.2, R31.1, R32.2, R33.2
unnamed: C52.2, R33.1, R34.2, U3.1
unnamed: C53.2, R36.1, R37.1, U3.7
unnamed: C54.2, R34.1, R35.2, R36.2
unnamed: D1.2 (A), J5.1, Q1.3 (D), TP22.1
unnamed: D1.1 (K), J4.1, R3.2, TP21.1
unnamed: D4.2 (A), R20.2
unnamed: D5.1 (K), R25.2, R26.1
unnamed: C48.2, D6.2 (A), D7.1 (K), R28.2, U1.3 (+)
unnamed: C34.1, C35.1, IC1.24 (AGDC)
unnamed: IC1.25 (CSI), TP1.1
unnamed: IC1.2 (CSO), TP2.1
unnamed: IC1.13 (RFO1), L1.1
unnamed: IC1.15 (RFO2), L2.1
unnamed: C22.1, C23.1, IC1.7 (VDD_A)
unnamed: C30.1, C31.1, IC1.11 (VDD_AM)
unnamed: C20.1, C21.1, IC1.3 (VDD_D)
unnamed: C26.1, C27.1, C32.1, C33.1, IC1.9 (VDD_RF), IC1.14 (VDD_DR)
unnamed: C1.2, IC1.5 (XTI), Y1.3
unnamed: C2.2, IC1.4 (XTO), Y1.1
unnamed: IC2.B1 (SW_1), IC2.B2 (SW_2), L3.2
unnamed: J3.10, R4.1, TP17.1
unnamed: J6.4, R8.2
unnamed: C43.1, C44.1, J7.1, R18.1, R19.1, R20.1, TP36.1, TP38.1
unnamed: J8.1, R15.2, R17.1, TP35.1, TP37.1
unnamed: Q1.1 (G), R4.2, R5.1
unnamed: Q2.3 (D), Q3.1 (G), Q4.1 (G), R14.2
unnamed: Q2.1 (G), R6.1, R13.2
unnamed: Q3.2 (S), R15.1
unnamed: Q4.3 (D), R17.2
unnamed: Q5.3 (D), R24.1
unnamed: Q5.1 (G), R26.2
unnamed: C50.1, R29.1, R30.2, U1.2 (-)
unnamed: C39.1, R10.1, R11.2, U1.5 (+)
unnamed: R19.2, R21.1, U2.1 (+)
unnamed: C52.1, R32.1, U3.2 (-)
unnamed: C53.1, R35.1, U3.6 (-)
SYS: C37.1, IC2.A3 (VIN), IC2.B3 (EN), J3.1, J3.2, J6.6, L3.1, R3.1, TP23.1, TP24.1
