CharlieYu4994/ClipperOne/(commit log)

2024-10-29 PCB: Re layout the iBTN board
    [iButton.kicad_pcb, iButton.kicad_sch]
2024-10-31 layout: finish the layout initially
    [main_board.kicad_pcb, power.kicad_sch]
2024-11-03 layout: cleanup tracks and vias
    [main_board.kicad_pcb]
2024-11-03 PCB: iButton Fix missing hole
    [iButton.kicad_pcb]
2024-11-04 layout: add some testpoints
    [main_board.kicad_pcb]
2024-11-04 layout: move the back button
    [main_board.kicad_pcb]
2024-11-04 silkscreen: start edit the silkscreens
    [main_board.kicad_pcb]
2024-11-07 layout: change some routes
    [main_board.kicad_pcb]
2024-11-07 footprint: fix sd card
    [main_board.kicad_pcb]
2024-11-07 sch: change sd card footprint
    [periphery.kicad_sch]
2024-11-07 change the Package of D10 to LTST-C19HE1WT
    [buttons.kicad_sch, cc1101.kicad_sch, lcd.kicad_sch, main_board.kicad_pcb, periphery.kicad_sch, power.kicad_sch, stm32.kicad_sch]
2024-11-07 layout: change tf card postion
    [main_board.kicad_pcb]
2024-11-07 misc: fix some fields
    [buttons.kicad_sch, cc1101.kicad_sch, lcd.kicad_sch, main_board.kicad_pcb, power.kicad_sch, stm32.kicad_sch]
2024-11-07 layout: change LED footprint
    [main_board.kicad_pcb, periphery.kicad_sch]
2024-11-07 layout finish change LED footprint
    [main_board.kicad_pcb]
2024-11-07 misc: fix conflict
    [main_board.kicad_pcb, periphery.kicad_sch]
2024-11-08 layout: add more stitching vias silkscreen: add more silkscreens
    [main_board.kicad_pcb]
2024-11-09 3D models rev4
    [Battery Plate_rev4_finalAdjustment.stl, button_back.stl, button_ok.stl, button_ring.stl, light_guide_group_x5.stl, sd lanyard bracket_rev2_fixBreak.stl, 上盖.stl, 下盖_rev2_fixHole.stl]
2024-11-09 Update Battery Plate_rev4_finalAdjustment.stl
    [Battery Plate_rev4_finalAdjustment.stl]
2024-11-09 PCB: nfc_rfid: adjust vibro touch point
    [nfc_rfid.kicad_pcb]
2024-11-09 PCB: nfc_rfid: add more stitching vias silkscreen: add more silkscreens
    [nfc_rfid.kicad_pcb]
2024-11-10 footprint: change sd card footprint
    [periphery.kicad_sch]
2024-11-10 PCB: Update silkscreen for main board
    [main_board.kicad_pcb]
2024-11-11 silkscreen: fix NTC silkscreen
    [main_board.kicad_pcb]
2024-11-11 layout: move the dummy NTC to bottom
    [main_board.kicad_pcb]
2024-11-11 silkscreen: change rev
    [main_board.kicad_pcb]
